ADeBona/X-haptics_ROS2_bridge/pads/pad_MSE/inflation.png

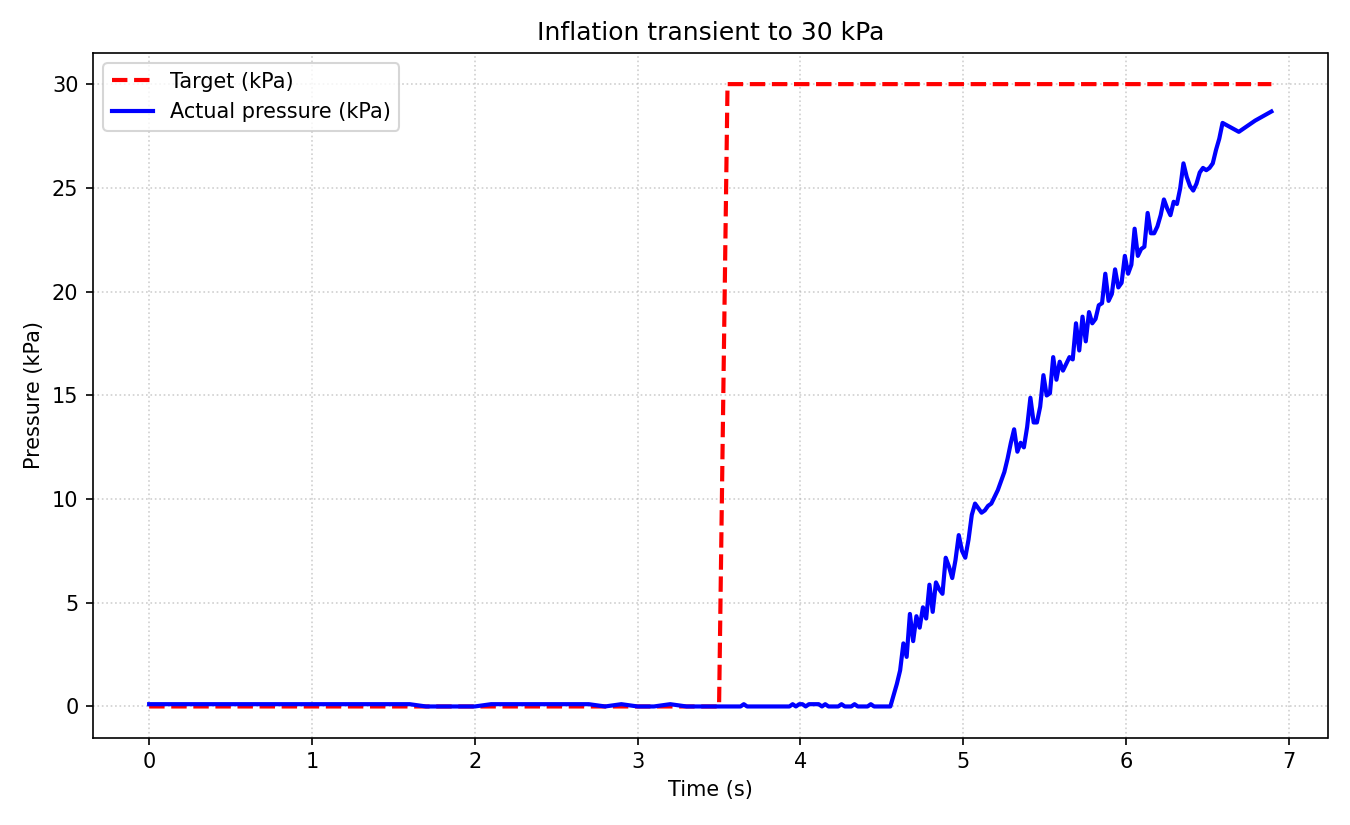
pads/pad_MSE/inflation.png
