ADeBona/X-haptics_ROS2_bridge/pads/pad_MSE/symmetry.png

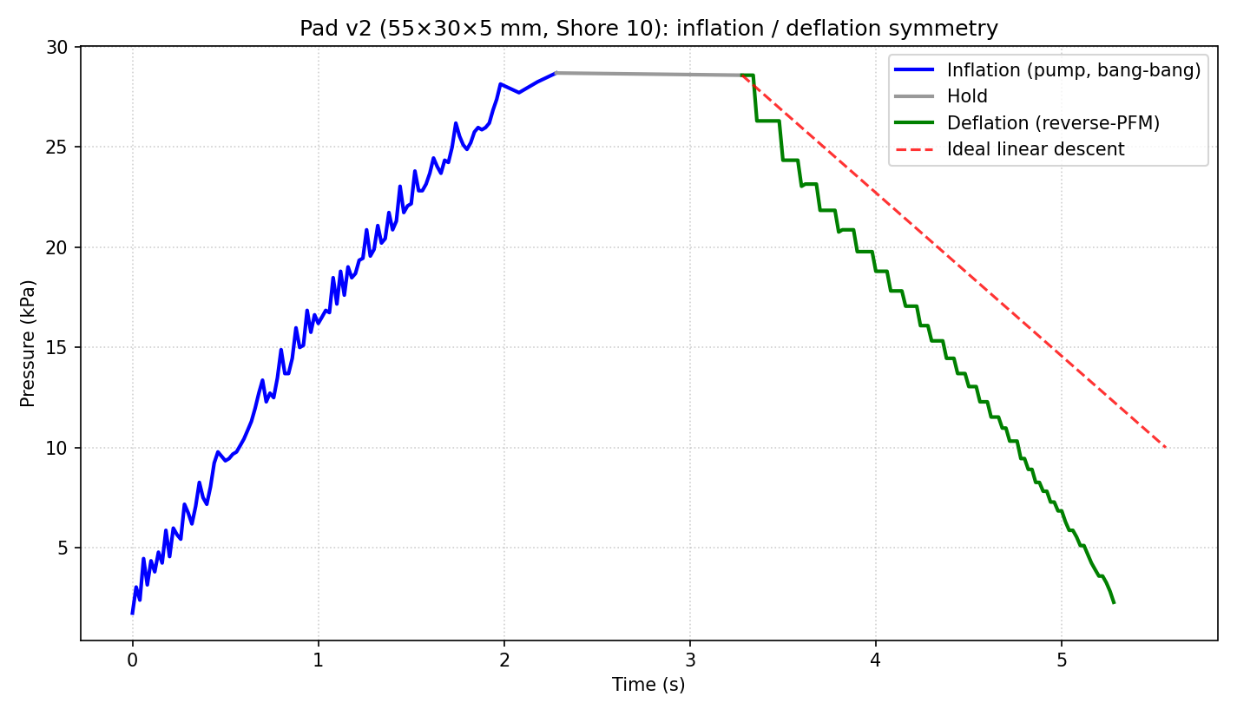
pads/pad_MSE/symmetry.png
