ADeBona/X-haptics_ROS2_bridge/pads/pad_v2_55x30_shore10/inflation.png

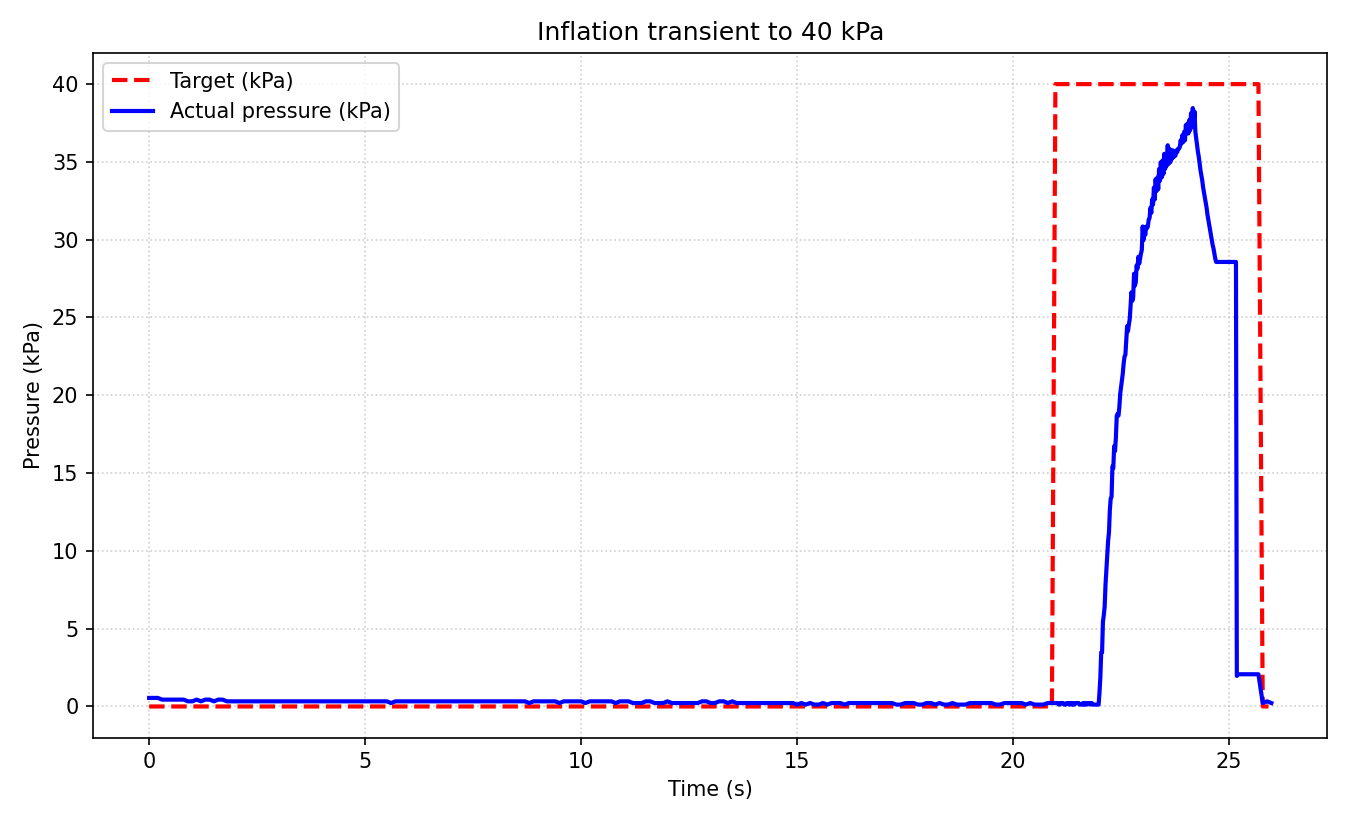
pads/pad_v2_55x30_shore10/inflation.png
