ADeBona/X-haptics_ROS2_bridge/GUIDE.md

# QUICK GUIDE — chi-Haptics Bridge

Every command runs **inside the Docker container** unless marked `[HOST]`.
Two separate workflows live in this repo:

* **Teleoperation** (§1–§7) — the production system: robot screw torque → pad pressure.

* **Pad characterisation** (§8–§11) — the test rig: measure and tune a new pad.

They use **different Arduino firmware**. Flash the right one before starting.

| Workflow | Sketch | Runs from |
| --- | --- | --- |
| Teleoperation | `arduino/pressure_tracker` | container (ROS) |
| Characterisation | `arduino/pad_characterisation` | `[HOST]` (plain Python) |

***

## 0. Start the container

`[HOST]` — build and start (first time, or after changing the Dockerfile):

```bash
cd ~/kinova_haptic_ws/docker
docker compose up -d --build
```

`[HOST]` — just start it (normal case):

```bash
cd ~/kinova_haptic_ws/docker
docker compose up -d
```

`[HOST]` — open a shell inside:

```bash
docker exec -it kinova_haptic_humble bash
```

**Mounts.** `docker-compose.yml` bind-mounts the whole repo to `/repo` inside
the container, plus `../src` a second time at `/ros2_ws/src` (the path colcon
expects). Both point at the same files on the Pi, so:

* Edit anywhere in the repo from the Pi (fast, no editor-in-container needed)
  — the container sees it immediately at `/repo/...`, and at `/ros2_ws/src/...`
  for the ROS package specifically.
* Anything written from inside the container under `/repo` or `/ros2_ws/src`
  lands on the Pi's disk — it survives the container being removed.
* `/ros2_ws/build`, `/ros2_ws/install`, `/ros2_ws/log` (colcon's own output)
  are **not** mounted — they live only in the container's writable layer and
  are regenerated by `colcon build`, so losing them on a `--force-recreate`
  costs a rebuild, not source.

Any change to `docker-compose.yml` itself (new mount, new env var) needs:

```bash
cd ~/kinova_haptic_ws/docker
docker compose up -d --force-recreate
```

***

## 1. Build the ROS package

Required after every edit to any `.py` file, and after every `--force-recreate`:

```bash
cd /ros2_ws
colcon build
source install/setup.bash
```

Check the executables registered:

```bash
ros2 pkg executables kinova_haptic_teleop
```

Expect: `fake_torque_pub`, `kinova_haptic_bridge`, `kinova_haptic_bridge_sim`.

The screw-torque and pad-mapping math lives in pure, ROS-free functions
(`kinova_haptic_teleop/screw_torque.py`, `kinova_haptic_teleop/pad_csv_logger.py`)
so they can be unit-tested without a build or a robot:

```bash
cd /ros2_ws/src/kinova_haptic_teleop
python3 -m pytest test/test_screw_torque.py -v
```

***

## 2. FAKE mode — bench test, no robot

**Terminal 1** — the bridge:

```bash
docker exec -it kinova_haptic_humble bash
source install/setup.bash
ros2 run kinova_haptic_teleop kinova_haptic_bridge_sim
```

**Terminal 2** — keyboard torque simulator (UP/DOWN arrows, `q` to quit):

```bash
docker exec -it kinova_haptic_humble bash
source install/setup.bash
ros2 run kinova_haptic_teleop fake_torque_pub
```

Publish a fixed value instead of using the keyboard:

```bash
ros2 topic pub /kinova/sim_torque std_msgs/msg/Float32 "{data: 4.0}" -r 10
```

Test deflation between two **non-zero** targets — a target of 0 triggers the full purge, not PFM:

```bash
ros2 topic pub /kinova/sim_torque std_msgs/msg/Float32 "{data: 1.0}" -r 10
```

`kinova_haptic_bridge_sim` is unaffected by everything below — it still maps
`|torque|` straight to pressure with no screw-torque extraction, tare, or
pad-group logic. Fine for bench-testing the serial link; not representative
of REAL mode's behaviour.

***

## 3. REAL mode — with the robot

Preferred — use the params file:

```bash
docker exec -it kinova_haptic_humble bash
source install/setup.bash
ros2 run kinova_haptic_teleop kinova_haptic_bridge --ros-args \
  --params-file /config/bridge_real.yaml
```

if needed
```bash
ros2 topic pub /kinova_haptic_bridge/tare std_msgs/msg/Empty "{}" --once
```

Command line, for a one-off override:

```bash
docker exec -it kinova_haptic_humble bash
source install/setup.bash
ros2 run kinova_haptic_teleop kinova_haptic_bridge --ros-args \
  -p serial_port:=/dev/serial/by-id/usb-Arduino_UNO_WiFi_R4_CMSIS-DAP_F412FA654890-if01 \
  -p axis_vertical:=2 \
  -p axis_lateral:=0 \
  -p lever_sign:=-1
```

***

## 4. The params file

`config/bridge_real.yaml` on the host, mounted read-only at `/config/` inside the container. Edit in VS Code, no rebuild needed — just restart the node.

```yaml
/kinova_haptic_bridge:
  ros__parameters:
    serial_port: "/dev/serial/by-id/usb-Arduino_UNO_WiFi_R4_CMSIS-DAP_F412FA654890-if01"
    auto_recover: true

    axis_vertical: 2
    axis_lateral: 0
    lever_L: 0.20
    lever_sign: 1

    tau_deadband: 0.05
    tau_max: 2.0
    pressure_bias: 0.0
    pressure_span: 40.0

    tare_samples: 20

    csv_log_path: "/repo/logs/kinova_haptic_bridge_log.csv"
```

The screw-torque model (fixed by the task, not tunable):

```
tau_screw = tau_vertical + lever_sign * lever_L * f_lateral
```

`tau_vertical` = `wrench.torque` component at index `axis_vertical`.
`f_lateral` = `wrench.force` component at index `axis_lateral`. Index order is
`0=x, 1=y, 2=z`. This removes the false twist a sideways force produces at the
wrist because the nut sits on a lever arm — it does **not** compensate gravity,
and there is no TF lookup or rotation matrix involved (the task assumes the
end effector stays parallel to the table, so the sensor's vertical axis is
always the bolt axis).

| Parameter | Meaning | Tuning |
| --- | --- | --- |
| `serial_port` | Arduino device. Use the `by-id` path — it survives re-enumeration, `ttyACM0` may not | — |
| `auto_recover` | force USB re-enumeration when telemetry stalls | leave `true` |
| `axis_vertical` | index (0/1/2) of the torque axis about the bolt | **not yet confirmed** — see §6 |
| `axis_lateral` | index (0/1/2) of the force axis feeding the lever-arm correction | **not yet confirmed** — see §6 |
| `lever_L` | metres from sensor origin to nut centre | measure on the actual driver/socket |
| `lever_sign` | +1 or -1, sign of the lever-arm correction term | flip if `tau_perp_mag` in the CSV log doesn't shrink relative to raw |
| `tau_deadband` | Nm of tared torque ignored before any pressure is commanded | raise if idle output is noisy |
| `tau_max` | Nm of tared torque mapping to full `pressure_span` | peak seen during a real screwing pass |
| `pressure_bias` | kPa floor both pad groups sit at when `u = 0` | 0 unless the pad needs a resting preload |
| `pressure_span` | kPa added on top of bias at `u = ±1` | 40 leaves headroom under the firmware's 60 kPa clamp |
| `tare_samples` | samples averaged into the frozen tare offset on `~/tare` | 20 at 20 Hz ≈ 1 s of quiet hold |
| `csv_log_path` | where the 20 Hz validation CSV is written | point it under `/repo` so the file survives the container |

***

## 5. Monitoring

What the Arduino reports it is actually doing:

```bash
ros2 topic echo /pressure/actual_kpa
ros2 topic echo /pressure/target_kpa_echo
```

`target_kpa_echo` is ground truth — it is what the **Arduino** believes the target is, not what the bridge sent. If they disagree, commands are not landing.

Raw serial, bypassing ROS entirely (stop the bridge first):

```bash
python3 -c "
import serial,time
s=serial.Serial('/dev/ttyACM0',115200,timeout=2); time.sleep(3)
[print(s.readline().decode(errors='ignore').strip()) for _ in range(40)]
"
```

Shows the `State:` field — `IDLE`, `INFLATE`, `DEFLATE`, `HOLD`, `PURGE`.

**The CSV validation log** at `csv_log_path` is the other half of the picture
— it's written every 20 Hz tick regardless of whether a new command was sent,
with columns `t, fx, fy, fz, tx, ty, tz, tau_raw, tau_screw, tau_perp_mag, u,
pA, pB`. Only `pA` is ever actually sent to the Arduino (one pneumatic channel
exists today); `pB` is logged so nothing needs to change when a second
channel is wired in. Tail it live:

```bash
tail -f /repo/logs/kinova_haptic_bridge_log.csv
```

***

## 6. Confirming the axis and taring

The sensor axis mapping (`axis_vertical`, `axis_lateral`, `lever_sign`) is
**not confirmed** — determine it empirically, then tare. For the detailed,
one-motion-at-a-time walkthrough with what to watch for at each step, see
[`AXIS_CALIBRATION.md`](AXIS_CALIBRATION.md). Short version:

1. Start the bridge with the arm at rest, not touching anything. Trigger a
   tare so the frozen offset is captured against the true at-rest reading:

   ```bash
   ros2 topic pub /kinova_haptic_bridge/tare std_msgs/msg/Empty "{}" --once
   ```

   Watch the log for `Tare captured: offset=...` (`tare_samples` samples get
   averaged, then the offset freezes — it will not drift after that, unlike
   the old gravity-baseline EMA this replaced).

2. Move the arm through free space. `tau_screw` in the CSV should stay near
   zero. If it doesn't, re-tare after the move rather than chasing it with
   `tau_deadband`.

3. By hand, turn the nut driver as if tightening (not loosening — you don't
   feel torque unscrewing, so there is nothing to render there). Watch
   `tau_raw` vs `tau_perp_mag` in the CSV:
   - If `tau_perp_mag` is large relative to `tau_raw`, `axis_vertical` is
     probably wrong — try the other two indices.
   - Push sideways on the driver (no twist) and watch `tau_screw` versus
     `tau_raw`: if the lever correction is helping, `tau_screw` should move
     *less* than `tau_raw` does. If it moves *more*, flip `lever_sign`.
4. Confirm sign convention: tightening should drive `u > 0` (`pA` above
   `pressure_bias`) in the CSV. If tightening instead shows up as `u < 0`,
   flip `lever_sign` or swap which physical direction you call tightening —
   don't add a new sign parameter for it, the existing ones are sufficient.
5. Set `tau_max` to the peak tared `tau_screw` seen during a full screwing
   pass, and `tau_deadband` just above the at-rest noise floor.

Reset the offset back to zero at any point with:

```bash
ros2 topic pub /kinova_haptic_bridge/reset_tare std_msgs/msg/Empty "{}" --once
```

***

## 7. Offline validation — replay a rosbag, no robot

`scripts/replay_screw_torque_bag.py` runs the *same* pure functions the live
bridge uses (`screw_torque.py`, `pad_csv_logger.py`) against a recorded
rosbag2, and writes an identical CSV. Needs `rosbag2_py`, so run it inside
the container (visible at `/repo/scripts` thanks to the mount in §0):

```bash
docker exec -it kinova_haptic_humble bash
source install/setup.bash
python3 /repo/scripts/replay_screw_torque_bag.py \
  --bag /repo/bags/my_recording \
  --topic /ft_sensor_link/wrench \
  --axis-vertical 2 --axis-lateral 0 --lever-sign -1 \
  --out /repo/logs/replayed.csv
```

Pass `--tare-at-start` to simulate triggering `~/tare` on the first sample of
the bag, matching what the live node would freeze if tared at t=0. Useful for
trying different `axis_vertical`/`axis_lateral`/`lever_sign` combinations
against one recording without touching the robot.

***

## 8. Pad characterisation — overview

Run this whenever a new pad design is built. Three phases:

1. **Safe limit** — step pressure manually until you judge the pad is at its limit.
2. **Inflation transient** — measure the rise time. This becomes `T_ref`.
3. **Deflation optimisation** — Bayesian optimisation of the reverse-PFM bounds so the descent approximates a linear ramp of duration `T_ref`.

Results go in `pads/<pad_name>/`, one folder per design, so successive pads stay comparable.

**Flash the characterisation firmware first.** The scripts speak a different serial protocol (`U`/`D`/`I`/`F` commands, `D,` telemetry) and will sit silent against `pressure_tracker.ino`.

`[HOST]`:

```bash
sudo lsof /dev/ttyACM0     # must print nothing — see §12 if the bridge holds it
cd ~/kinova_haptic_ws/arduino
./flash_arduino.sh         # choose 2) pad_characterisation
```

Scripts run on the **host**, not in the container — they need only pyserial, numpy and matplotlib, no ROS:

```bash
sudo apt install python3-numpy python3-matplotlib -y
cd ~/kinova_haptic_ws/scripts
```

***

## 9. Phase 1 & 2 — safe limit and inflation

```bash
python3 pad_logger.py --port /dev/ttyACM0 --out ../pads/pad_v2_55x30_shore10
```

Menu:

* `1` manual stepping — UP/DOWN in 2 kPa steps, `z` vents, `q` exits. Reports the max reached.

* `2` inflation test — vent, settle, full pump to target. Reports **RISE TIME**, writes `inflation.csv` and `inflation.png`.

* `3` single deflation test — one descent at chosen `T_max`/`T_min`. Useful for sanity-checking before a full optimisation run.

**Do phase 1 with the pad shielded, not on your arm.** The firmware refuses to exceed `HARD_CEILING_KPA = 80.0`, but you are looking for where the pad fails.

Note the rise time from phase 2 — that is `--tref` for the optimiser.

A closed-loop hold will *not* reveal a leak: bang-bang keeps topping up and hides it. The only open-loop window is the deflation test's settle phase, which is why the firmware tops the pad up immediately before each descent.

***

## 10. Phase 3 — deflation optimisation

```bash
python3 pad_optimize.py --port /dev/ttyACM0 \
  --start 30 --tref 2244 --trials 25 \
  --out ../pads/pad_v2_55x30_shore10
```

25 trials at roughly 15–25 s each, so about 10 minutes. First 6 are random seeds, the rest Bayesian (GP surrogate, Matern 5/2, Expected Improvement).

Watch the printed columns:

| Column | Meaning | What to check |
| --- | --- | --- |
| `MSE`  | error against the ideal linear descent | should drop sharply once BO starts |
| `dur`  | actual descent duration | compare against `--tref` |
| `p0` | **measured** start pressure | must be consistent across trials, and close to `--start` |
| `n` | samples in the trace | too few means the descent terminated early |

`p0` is the one to watch. If it varies by more than \~1 kPa, trials are not comparable and the optimum is fitting noise rather than parameters.

Outputs: `optimum.json`, `optimisation_history.csv`, `deflation_best.csv`.

Combined figure:

```bash
python3 plot_characterisation.py --dir ../pads/pad_v2_55x30_shore10
```

Then paste `T_max_ms` / `T_min_ms` from `optimum.json` into `pressure_tracker.ino` as `settle_max` / `settle_min`.

**Anchor mismatch to watch for.** The production firmware interpolates between fixed anchors (10 and 50 kPa). The characterisation rig anchors on the test target and `DEFLATE_END_KPA`. If you characterise at a different start pressure, the bounds will not transfer directly — either characterise at the production anchor, or update the production anchors to match.

***

## 11. Reading the characterisation traces

**Sensor transients during bursts.** While the valve is open, air flows past the sensor and the reading dips sharply, recovering over roughly 60–80 ms after close. At fast cycling the off-period is shorter than that recovery, so the firmware latches one clean sample immediately *before* each burst rather than trying to find a quiet window afterwards. The logged curve should be monotonic; visible spikes mean the latch is not being applied.

**Steps per descent.** `RESULT,DEFLATE` reports the burst count. Around 30 bursts over a 20 kPa descent is \~0.6 kPa per burst — below the perceptual threshold for pressure, so the system is not volume-limited. If perceived roughness persists at that resolution, the cause is the valve's mechanical impulse travelling down the tubing, not the pressure steps. That is fixed by decoupling the valve (mount it off the pad, compliant tubing, foam under the body), not by control parameters.

**Shape versus duration.** The MSE objective weights profile shape more heavily than total duration, so the winning candidate may finish faster than `T_ref`. If matching the inflation duration matters more than linearity, the duration term needs explicit weighting in `score()`.

***

## 12. Flashing the Arduino

`[HOST]` — the port must be free. `arduino-cli` sends a 1200-baud touch to enter the bootloader; if anything holds the port it cannot, and the upload fails with `Device unsupported`.

```bash
sudo lsof /dev/ttyACM0
```

If the bridge appears, stop it:

```bash
sudo kill -INT <PID>
# or, if it is inside the container:
cd ~/kinova_haptic_ws/docker && docker compose stop
```

Use `-INT` (Ctrl-C), not `-9`. It lets the ROS2 node run its shutdown handlers, which park the pump/valve pins safely instead of leaving them latched mid-cycle. Only escalate to `-9` if `-INT` doesn't clear it after a few seconds.

The bridge is usually just a foreground `ros2 run` left in a terminal (no systemd unit, no cron, nothing respawns it) — check with `ps -p <PID> -o ppid,cmd` if you want to confirm before killing. Once it's dead it stays dead; it only comes back if someone runs it again.

Then:

```bash
cd ~/kinova_haptic_ws/arduino
./flash_arduino.sh
```

If it still reports `Device unsupported`: **double-tap the reset button** to force the bootloader, check the new port with `ls -l /dev/serial/by-id/`, and upload to that port explicitly.

***

## 13. When something breaks

**Arduino goes deaf, reset button does not help.** The USB CDC endpoint has stalled while still enumerated — only a bus-level re-enumeration clears it. `auto_recover: true` handles this automatically in the bridge. Manually, `[HOST]`:

```bash
sudo python3 ~/kinova_haptic_ws/scripts/usb_reset.py
```

**Nothing inflates but telemetry looks fine.** The external DC supply for the pump and valve is not connected. This has caused this exact symptom more than once.

**Log alternates between two values.** Two publishers on the topic — usually a ghost node from a closed terminal:

```bash
ps aux | grep -E "fake_torque|kinova_haptic" | grep -v grep
kill <PID>
```

`ros2 node list` collapses duplicate node names, so it will *not* show the duplicate. Use `ros2 topic info <topic> --verbose` and check the publisher count.

**`tau_screw` never settles near zero at rest.** The tare offset hasn't been captured yet, or was captured while the arm was loaded — trigger `~/tare` again with the arm genuinely at rest (§6). This is a frozen offset, not an adapting baseline, so a bad capture stays bad until you re-tare.

**`u` pins at ±1 immediately.** `tau_max` is set too low for the actual torque range — check the CSV's `tau_screw` column for the real peak and raise it.

**Deflation test inflates and holds forever.** The settle phase is not completing. Check the `State:` field in telemetry — `DEF_SETTLE` that never advances to `DEF_RUN` means the timer is being reset each pass.

**Arrow keys do nothing / nothing inflates, but** **`pad_logger.py`** **says "Connected."** Check port contention first — `pad_logger.py` opening the port successfully does not mean it has it exclusively:

```bash
sudo lsof /dev/ttyACM0
```

If `kinova_haptic_bridge` (or anything else) shows up, the bridge is racing `pad_logger.py` for the same serial line and your `U`/`D` keys land nowhere. Stop it per §12, confirm `lsof` prints nothing, then reconnect.

If the port is clean and it's still silent, the cause is nested TTYs (tmux inside VS Code inside `docker exec`) swallowing or splitting the arrow-key escape sequence — test in a plain SSH terminal.

**"No executable found".** You did not `colcon build`, or did not `source install/setup.bash`.

**Nodes on the same machine cannot see each other.** The CycloneDDS peer list needs `localhost` in it, otherwise disabling multicast also disables same-machine discovery.

**Valve gets very hot.** The production firmware caps continuous valve-on time and forces a cooldown, printing `VALVE:thermal cap`. If it heats at idle, the MOSFET gate is floating before `setup()` runs — fit a 10 kΩ pulldown from SIG to GND on both modules. Firmware cannot protect the pins before the firmware is running.

***

## 14. Daily commit

`[HOST]`:

```bash
cd ~/kinova_haptic_ws
git add -A
git commit -m "describe what changed"
git push
```

Tag a working milestone:

```bash
git tag -a v0.5-pad-v2-characterised -m "Pad v2 BO: T_max=85, T_min=37"
git push --tags
```
