ADeBona/X-haptics_ROS2_bridge/pads/pad_MSE/optimisation_history.csv

trial | origin | T_max | T_min | mse | duration_s | p_start_meas | samples
1 | random | 173.76195433750541 | 39.67653851402574 | 14.79952282422452 | 6.94 | 28.35 | 348
2 | random | 48.604440026600884 | 11.8180399081382 | 51.22039173088328 | 1.3 | 28.35 | 66
3 | random | 210.78675023205722 | 110.4031135005494 | 42.35433917291243 | 5.46 | 28.24 | 274
4 | random | 167.3935129111078 | 90.24462170823982 | 26.656210991172447 | 4.46 | 28.13 | 224
5 | random | 154.16124820773882 | 112.85796661665451 | 27.179758562079158 | 4.84 | 28.35 | 243
6 | random | 211.32924636552175 | 10.30123501871629 | 30.63049752966843 | 2.9 | 28.35 | 146
7 | BO | 158.29642192813645 | 52.114867053449984 | 14.761920085032308 | 3.32 | 28.35 | 167
8 | BO | 185.83791942471103 | 51.193602148973575 | 28.664341411486816 | 3.8 | 28.35 | 191
9 | BO | 148.53756052180165 | 38.73068070882343 | 12.268694807632643 | 3.02 | 28.35 | 152
10 | BO | 114.99948645318926 | 69.578704658107 | 8.79808644508097 | 3.46 | 28.24 | 174
11 | BO | 88.95653302413106 | 87.20066359670773 | 5.2189510368481375 | 3.26 | 27.92 | 164
12 | BO | 77.51689190122886 | 75.99399110181638 | 4.01382949105391 | 3.06 | 28.57 | 154
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
