ADeBona/X-haptics_ROS2_bridge/pads/pad_smooth/optimisation_history.csv

trial | origin | T_max | T_min | score | worst_step_kPa | burst_hz | ramp_mse | duration_s | p_start_meas | samples
1 | random | 173.76195433750541 | 54.28080423874833 | 9.82016355666667 | 1.5566666666666673 | 10.039370078740157 | 37.192335956371906 | 5.08 | 28.35 | 255
2 | random | 48.604440026600884 | 31.487487197567617 | 3.335835504445912 | 1.7733333333333334 | 23.78640776699029 | 22.570612519623225 | 2.06 | 28.46 | 104
3 | random | 210.78675023205722 | 112.14800195499495 | 32.212780890000005 | 1.5566666666666673 | 7.033248081841432 | 48.92976540472275 | 7.82 | 28.35 | 392
4 | random | 167.3935129111078 | 95.65469048855985 | 18.981308890000008 | 1.5933333333333337 | 8.125 | 36.38104065051013 | 6.4 | 28.57 | 321
5 | random | 154.16124820773882 | 114.15651814089914 | 25.05709289 | 1.4833333333333332 | 7.563025210084034 | 33.88898688792061 | 7.14 | 28.24 | 358
6 | random | 211.32924636552175 | 30.24646501531333 | 8.107550223333337 | 1.486666666666667 | 11.506276150627615 | 52.165336455588786 | 4.78 | 28.35 | 240
7 | BO | 93.9398562887585 | 30.02964508445794 | 2.8272635566666695 | 1.5200000000000007 | 17.857142857142858 | 3.435957061802605 | 3.08 | 28.35 | 155
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
