ADeBona/X-haptics_ROS2_bridge/(commit log)

2026-07-22 Split sim/real bridges; DTR reset pulse fixes R4 reconnect hang
    [kinova_haptic_bridge_sim.py, pressure_tracker.ino]
2026-07-23 Add arduino flash script, update cyclonedds config
2026-07-24 Add the Pad characterisation and Bayesian Optimisation Workflow
    [deflation_best.csv, inflation.csv, optimisation_history.csv]
2026-07-24 Update GUIDE.md with detailed pad characterisation workflow and Arduino flashing instructions
2026-07-24 Refactor code structure for improved readability and maintainability
    [deflation_150_60.csv]
2026-07-31 Remove obsolete deflation and inflation data files, add new inflation image, and delete unused optimization history and parameters.
    [deflation_150_60.csv, deflation_best.csv, inflation.csv, optimisation_history.csv]
2026-08-03 Update pressure tracker parameters and correct wrench topic in bridge
    [kinova_haptic_bridge.py, pressure_tracker.ino]
2026-08-05 feat: add offline replay script for screw-torque validation
    - Introduced `replay_screw_torque_bag.py` to replay rosbag2 data and validate screw-torque and pad-mapping functions without hardware.
    - Implemented `ScrewTorqueCsvLogger` in `pad_csv_logger.py` for consistent CSV logging format used in both live and replay scenarios.
    - Added pure functions for screw-torque extraction and pad pressure mapping in `screw_torque.py`, enabling unit testing without ROS dependencies.
    - Created unit tests in `test_screw_torque.py` to ensure the correctness of screw-torque calculations, pad pressure mappings, and tare estimation logic.
    [deflation_best.csv, inflation.csv, optimisation_history.csv]
2026-08-05 docs: update axis calibration instructions and add detailed walkthrough
2026-08-06 feat: update CycloneDDS configuration and add bridge log CSV file
    [kinova_haptic_bridge_log.csv]
2026-08-06 feat: add tighten_sign parameter for twist direction calibration
    - Introduced a new parameter 'tighten_sign' to determine which twist direction is considered "tightening".
    - Updated logging to include the new 'tighten_sign' parameter.
    - Adjusted torque calculation to apply 'tighten_sign' after tare adjustment, ensuring correct twist direction handling.
    - Added comments for clarity on the purpose of 'tighten_sign' and its relationship with 'lever_sign'.
    [kinova_haptic_bridge_log.csv]
2026-08-31 Implement code changes to enhance functionality and improve performance
    [kinova_haptic_bridge_log.csv]
2026-08-31 Implement feature X to enhance user experience and optimize performance
    [kinova_haptic_bridge_log.csv]
2026-09-02 Add standalone command-path latency probe for chi-Haptics pneumatic interface
    This new script measures the latency from torque readings to pump activation, providing insights into the performance of the kinova_haptic_bridge. It supports three modes: live, stimulus, and passive, allowing for flexible testing scenarios without modifying the existing bridge code. The implementation includes detailed logging and reporting of latency stages, ensuring accurate performance analysis.
2026-09-03 Enhance README and bridge code with new haptic topics; adjust pressure parameters and add Arduino pressure tracker
2026-09-09 Update GUIDE.md with tare command and adjust tau_deadband and pressure_span in bridge_real.yaml
